lauriens/micros/hardware docs/counter.png

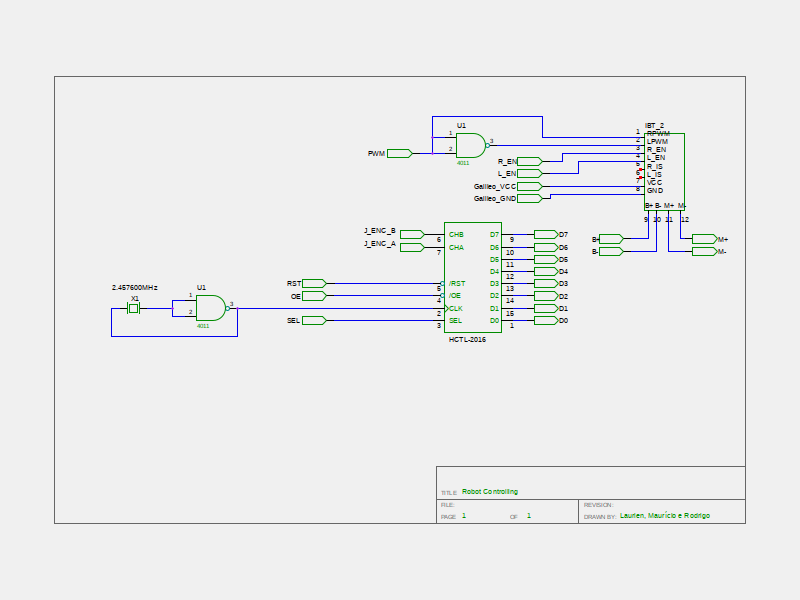
hardware docs/counter.png
