lauriens/micros/hardware docs/layoutmod1.png

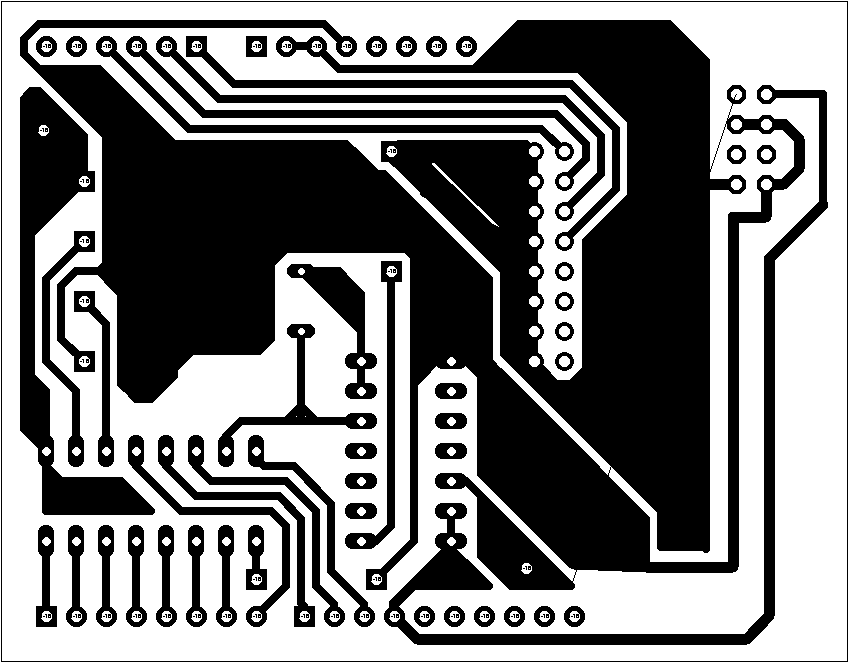
hardware docs/layoutmod1.png
