lauriens/micros/hardware docs/layoutOriginal.png

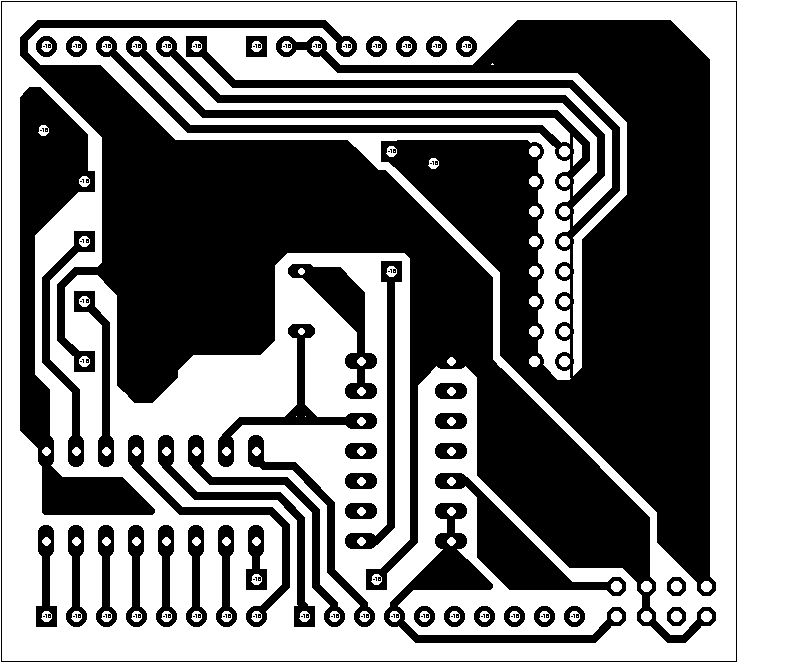
hardware docs/layoutOriginal.png
