lauriens/micros/hardware docs/layoutPCB.png

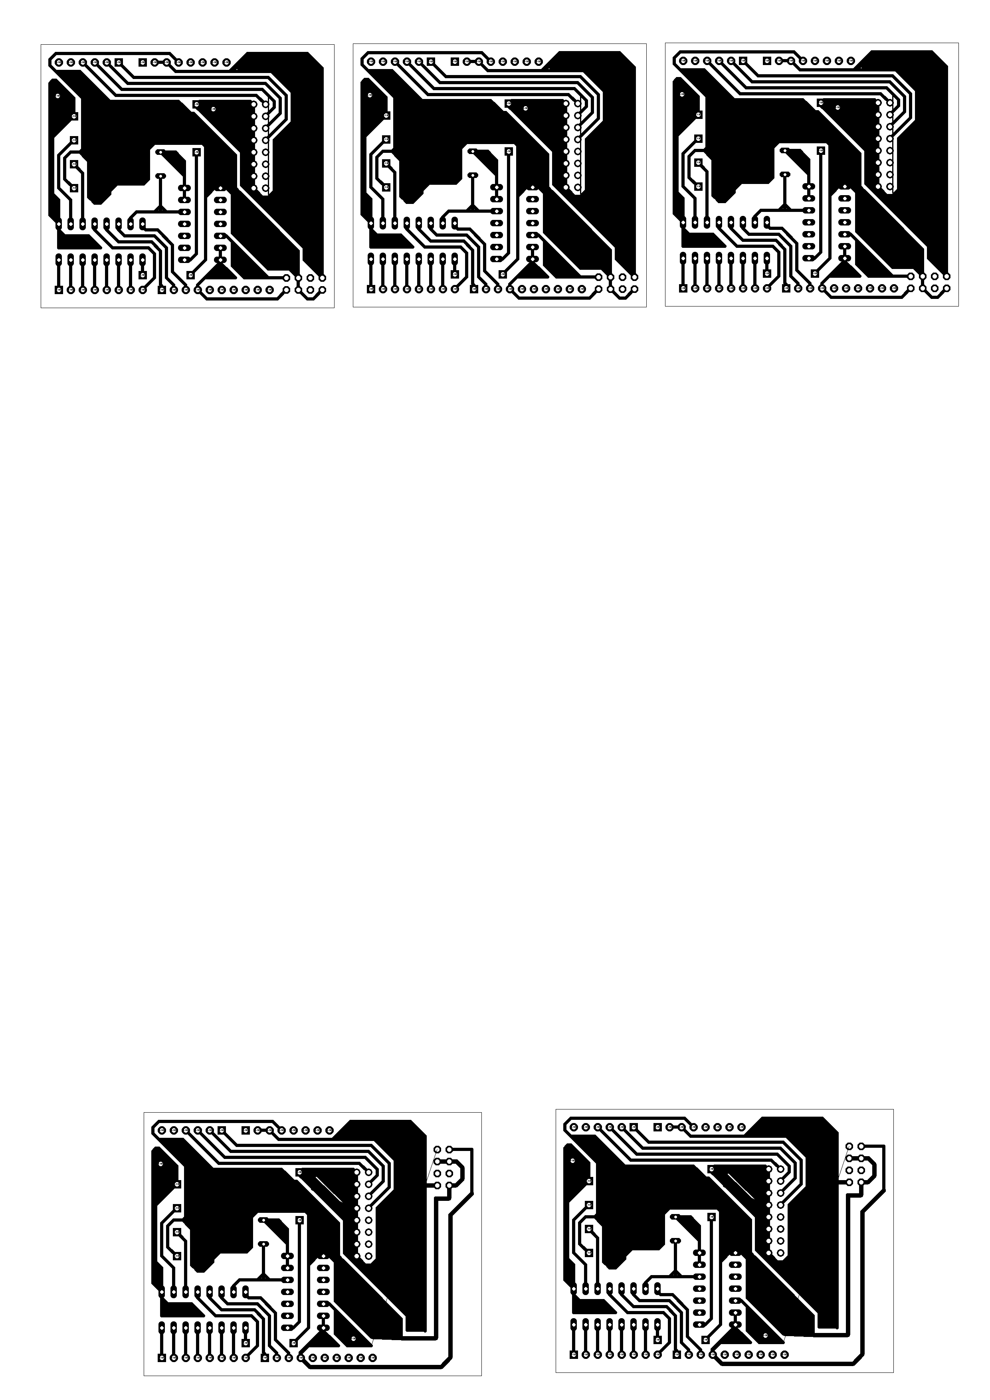
hardware docs/layoutPCB.png
