lauriens/micros/hardware docs/Board Laurien.dxf

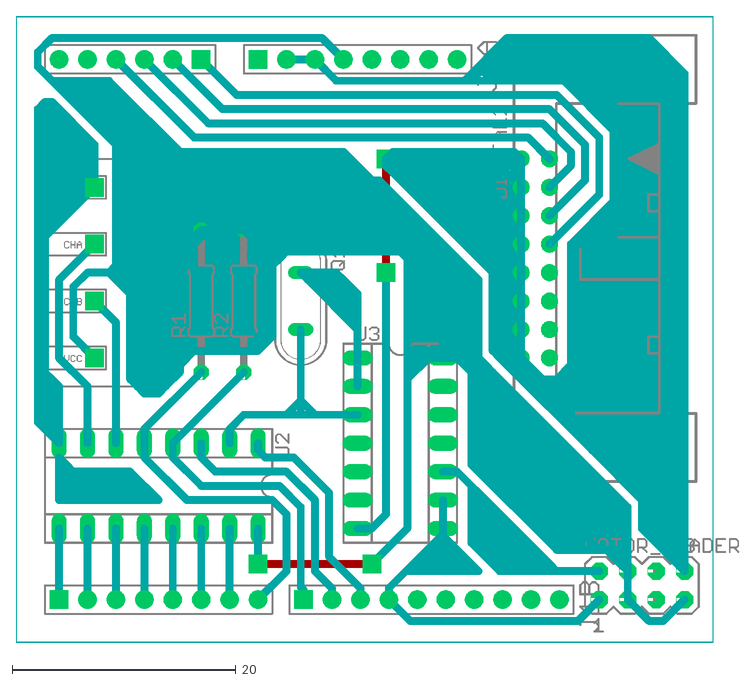
[picture p7: CAD file, 2019-04-27]
hardware docs/Board Laurien.dxf
64.6 x 56.0
