lauriens/micros/hardware docs/Board Mauri.brd

## EAGLE design hardware docs/Board Mauri.brd (2019-04-27)

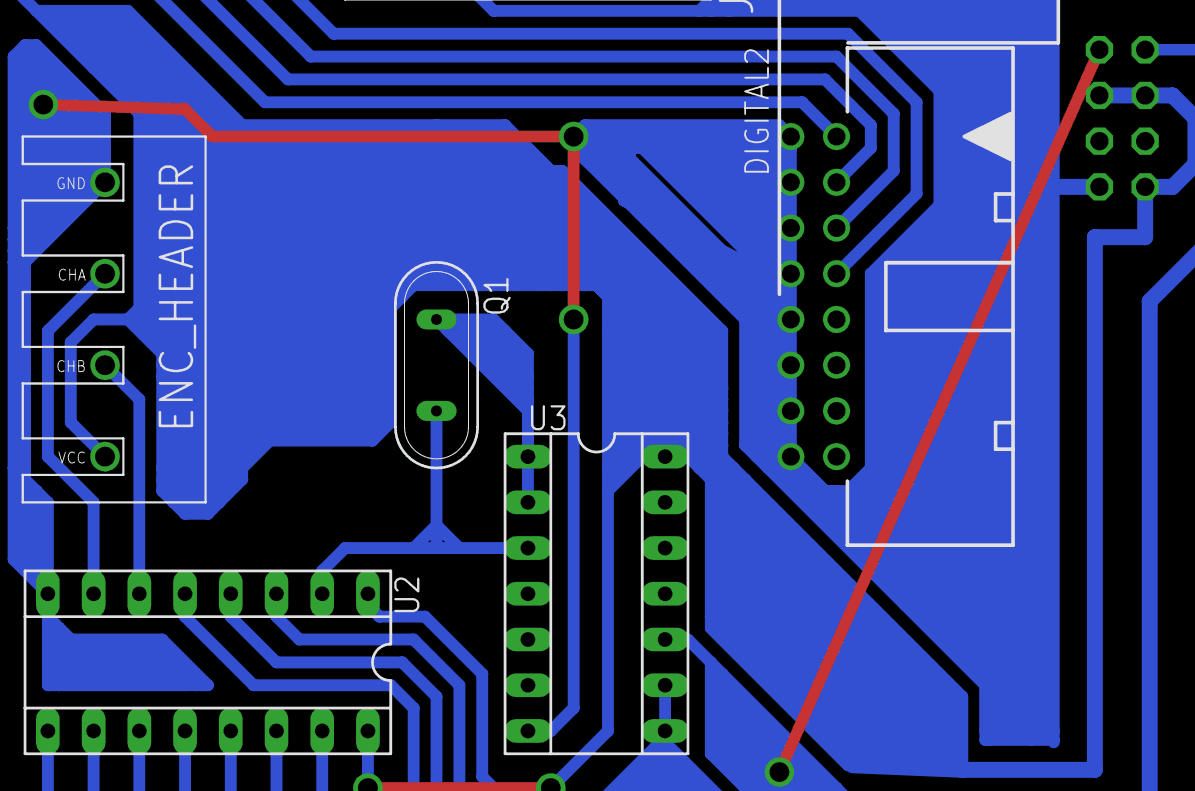
[picture p8: board Board Mauri.brd from above]

Board: 2 copper layers, 5 parts (1 on the bottom side), 7 nets.

Parts:
DIGITAL2: PAK100/2500-5-16
MOTOR_HEADER: MA04-2
Q1: QS
U2: SOCKET-16
U3: SOCKET-14

Connections:
S$2: Q1.1, U3.1, U3.2
S$4: U2.8, U3.7
S$7: MOTOR_HEADER.3, MOTOR_HEADER.4, MOTOR_HEADER.7, U2.16, U3.14
S$12: MOTOR_HEADER.2, U3.10
S$15: MOTOR_HEADER.1, U3.8, U3.9
S$24: Q1.2, U2.2, U3.3
S$40: DIGITAL2.1, DIGITAL2.3, DIGITAL2.5, DIGITAL2.7, DIGITAL2.9, DIGITAL2.11, DIGITAL2.13, DIGITAL2.15, MOTOR_HEADER.8
