lauriens/micros/(commit log)

2018-09-18 Trabalho Final v1
    [counter.sch]
2019-04-27 Atualizando repositório com a última versão do trabalho
    [Board Laurien.brd, Board Laurien.dxf, Board Mauri.brd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]
2019-04-28 Software documentation updated; added documentation for the libQuanser (libv1) and for the pid
2019-06-19 Added Script.c, to generate the start script (IT DOESN'T WORK YET)
    [Script.c, libv1.c]
